sergeyvfx/ez-kicad-library/(commit log)

2021-03-14 Add symbols for common sizes of capacitors
2021-03-20 Add 10085901-5015EHLF flat-flex connector
2021-03-20 Add F31S-1A7L1-11050 flat-flex connector
2021-03-20 Adjust flat-flex connectors for 1.27mm grid
2021-03-21 Add EMK212BB7106KG-T and UMK105B7104KV-FR capacitors
2021-03-21 Add UMK325AB7106KM-P capacitor
2021-03-21 Align capacitor fields with Digi-Key table
    Makes it easier to update.
2021-03-21 Make capacitance visible
    Got changed to invisible by mistake.
2021-03-21 Correct voltage rating of UMK105B7104KV-FR
    Would be really nice to be able to sue some sort of octopart or
    digikey API to automate this.
2021-03-21 Add various power rails
2021-03-21 Resistor: Add CRGCQ0402F10K
2021-03-21 Resistor: Add CRGCQ0402F8K2
2021-03-21 Resistor: Add CRGCQ0402F82K
2021-03-21 Elec Capacitor: Add A768KE686M1GLAE038
    technically, it is polymer, but at this time does not seem like it
    worth adding an extra library.
2021-03-21 Resistor: Add CRGCQ0402F33K
2021-03-21 Diode: Add 1N914BWT
2021-04-03 Add switch MCSLPT4644B1TR
2021-04-03 Add +3v power rail
2021-04-03 Add sideways 6pin 2.54mm pitch socket
2021-04-05 LED: Add 5977703607F
2021-04-11 Fix pin grid for 5977703607F
2021-06-13 Add ground work for RF connectors
    Currently only Coaxial symbol is added. No footprints, because this is
    harder to do with the current intended directory layout.
2021-06-13 Add 3d shape for 1mm board edge SMA connector
    Not ideal because of lack of smooth shading, but should be good
    enough for quick previews.
2021-06-13 Add SMA boardedge footprint
2021-07-10 Fix misaligned grid in coax connector
2023-03-07 Add common power rails for USB-C PD controller
2023-03-07 Add ESDA25W TVS diode
    The diode library is now converted to the new KiCAD format.
2023-03-07 Add ESDA25P35 TVS diode
2023-03-07 Add BAT54 Schottky diode
2023-03-07 Diode: Migrate description to built-in property
2023-03-07 Move ceramic capacitor and resistors to the new format
    Additionally, add the following capacitors:
    - C1206C475K5RACTU
    - UMK107AB7105KA-T
2023-03-07 Various changes to resistors and capacitors
    - Added components needed by typical STUSB4500 application
    - Cleanup of descriptions
2023-03-08 Correct footprint manufacturing type
    Those are SMD, but settings were set to TH.
2023-03-08 Fix +1.2v symbol connected to 2.7v rail
2023-03-12 Correct power rail for VBOS symbol
    It was connected to VSNK by accident.
2023-03-12 Add BQ24061 Li-Ion charger
2023-03-12 Add CPF-A-0402B200RE
    RES SMD 200 OHM 0.1% 1/16W 0402
2023-03-12 Add 0.47 uF ceramic capacitors
    - MSASL105SB7474MFNA01
    - UMK107B7474KA-TR
2023-03-12 Add HSMZ-C170
    LED RED DIFFUSED CHIP SMD
2023-03-12 Correct TMR pin electrical type of BQ29706DSER
2023-03-12 Add 300 Ohm and 2.2 kOhm resistors
    - CRGCQ0402F330R
    - CRGCQ0402F2K2
2023-03-12 BQ29706DSER: Fix unconnected pin 1 warning
2023-03-20 Add CSD16406Q3
    MOSFET N-CH 25V 19A/60A 8VSON
2023-04-10 Add HSMC-C280 and HSMG-C280 diodes
2023-04-10 Add MP28167GQ-P
    Buck-Boost Switching Regulator IC Positive Fixed 5V 1 Output 3A 16-PowerVFQFN
2023-04-11 Add 21.5k and 499k resistors
2023-04-11 Space pins of MP28167GQ-P
    Makes it easier to draw the reference schematic.
2023-04-11 Add 22nF capacitor
    MSAST105SB7224MFNB25
    0.22 µF ±20% 25V Ceramic Capacitor X7R 0402 (1005 Metric)
2023-04-11 Add 22uF capacitor
    C1210C226K3RAC7800
    22 µF ±10% 25V Ceramic Capacitor X7R 1210 (3225 Metric)
2023-04-14 Update MP28167GQ-P
    Use Unspecified type for unconnected pins, otherwise it is not
    possible to tight them to ground.
2023-04-15 Update pin names for STUSB4500LQTR
    They were named after the STUSB4500QTR symbol.
2023-04-16 Add EEF-CX0J101R
    CAP ALUM POLY 100UF 20% 6.3V SMD
    The height might be a bit off, as an existing 3d body from
    the KiCAD library is used.
2023-04-16 Add T491X107M025AT
    CAP TANT 100UF 20% 25V 2917
    Also renamed footprint of the EEF-CX0J101R to avoid naming
    conflicts and ambiguity.
2023-04-16 Add 74LVC1G07SE-7
    IC BUF NON-INVERT 5.5V SOT353
2023-04-16 Add switch 450404015514
    MINI SLIDE SWITCH 6.7 X 2.7 MM.
2023-04-16 Add non-staggered 3pin generic pin header
2023-04-16 Add FSUSB42MUX
    IC USB SWITCH DPDT 10MSOP
2023-04-19 Add CPF0402B5K1E1
    5.1 kOhms ±0.1% 0.063W, 1/16W Chip Resistor 0402 (1005 Metric) Thin Film
2023-04-22 USB2514BT/M2: Make symbol pins longer
    Makes it easer to read, and also solves intersection of pin
    numbers with pin symbols.
2023-04-22 USB2514BT/M2: Swap data + and - lanes
    Match other interface chips and the USB connectors where
    the positive lane is at the top.
2023-04-22 Add 629104151021
    CONN RCPT USB2.0 TYPEA 4P SMD RA
    Use the footprint for the new PCN.
    Need verification and the model file change after it becomes
    active.
2023-04-22 Add AP22653W6-7
    Power Switch/Driver 1:1 P-Channel 2.1A SOT-26
2023-04-22 Use upright labels for footprints
    Matches footprints started in the previous version of KiCAD.
2023-04-22 Fix typo in ILIM pin name for AP22653W6-7
2023-04-23 Add TPD2EUSB30DRTR
    8V Clamp 1A (8/20µs) Ipp Tvs Diode Surface Mount SOT-3
2023-04-23 Add TPD4EUSB30DQAR
    8V Clamp 1A (8/20µs) Ipp Tvs Diode Surface Mount 10-USON (2.5x1)
2023-04-23 Add F305-1A7H1-21022-E100
    CONN FFC BOTTOM 22POS 0.5MM R/A
2023-04-24 Set SMD footprints as such
    Resolves DRC.
2023-04-24 Add courtyard to generic connector footprints
2023-04-30 Add library for mounting holes
2023-08-11 Add 9774040151R
    Round Standoff Threaded M2.5x0.45 Steel 0.157" (4.00mm)
2024-07-15 Add 9774040243R
    ROUND STANDOFF M2X0.4 STEEL 4MM
2024-07-15 Update 9774040243R: use Cut Tape (CT) packaging
2024-07-15 Update 3d model of QFN-24-1EP_4x4mm_P0.5mm_EP2.7x2.7mm
    KiCAD 8 does not have a model for 2.7mm EP, so use 2.6mm
    which should not be causing any visual difference.
2024-07-21 Add S4B-PH-SM4-TB
    CONN HEADER SMD R/A 4POS 2MM
2024-07-21 Cleanup: Update syntax for the new KiCAD versions
2024-07-21 Cleanup: Specify footprint library version
2024-07-21 Add 2x20 generic connectors
2024-07-21 Add non-connected mechanical mounting hole
2024-07-21 Add CRGCQ0402F10R
    RES 10 OHM 1% 1/16W 0402
2024-07-21 Reduce length of capacitor symbol
    Makes it easier to place capacitor between two adjacent pins
    of an IC.
2024-07-21 Add 399-13068-1-ND
    CAP CER 4.7UF 6.3V X5R 0402
2024-07-21 Add C0402C105K4PAC7867
    CAP CER 1UF 16V X5R 0402
2024-07-21 Add CRGCQ0402F22R
    RES 22 OHM 1% 1/16W 0402
2024-07-23 Add +1V8 power symbol
2024-07-23 Add RT9193-33GB
    IC REG LINEAR 3.3V 300MA SOT23-5
2024-07-23 Add RT9193-18GB
    IC REG LINEAR 1.8V 300MA SOT23-5
2024-07-23 Add C0603C226M9PAC7867
    CAP CER 22UF 6.3V X5R 0603
2024-07-23 Add UMK105B7103KV-F
    CAP CER 10000PF 50V X7R 0402
2024-07-24 Add ESDA6V1BC6
    TVS DIODE 5VWM SOT23-6
2024-07-24 Add C0402C330K5RACTU
    CAP CER 33PF 50V X7R 0402
2024-07-24 WM8962BECSN/R: Fix type of charge-pump pins
2024-07-24 Add PWR_FLAG
    Special symbol for telling ERC where power comes from.
2024-07-25 WM8962BECSN/R: Set pad size to 0.264
    Based on IPC table, allows to fan-out the BGA with the
    extended JLCPCB tolerances.
2025-06-21 Add non-plated mounting hole M2.5 2.7mm drill 5.0mm outer
2025-06-22 Add NT1R3000
    STANDOFF FOR MM60-52B1-B1 3.9MM
2025-06-22 Add 0788641001 and mating pad
    CONN SPRING BATTERY 6POS SMD
2025-06-22 Fix incorrect case in Mechanical.3dshapes
2025-07-29 Add AP3441SHE-7B
    IC REG BUCK ADJ 3A UDFN20208
2025-07-30 AP7361C-FGE-7: Correct OUT pin type
